cetuspcr/Cetus-PCR/assets/background_clean.png

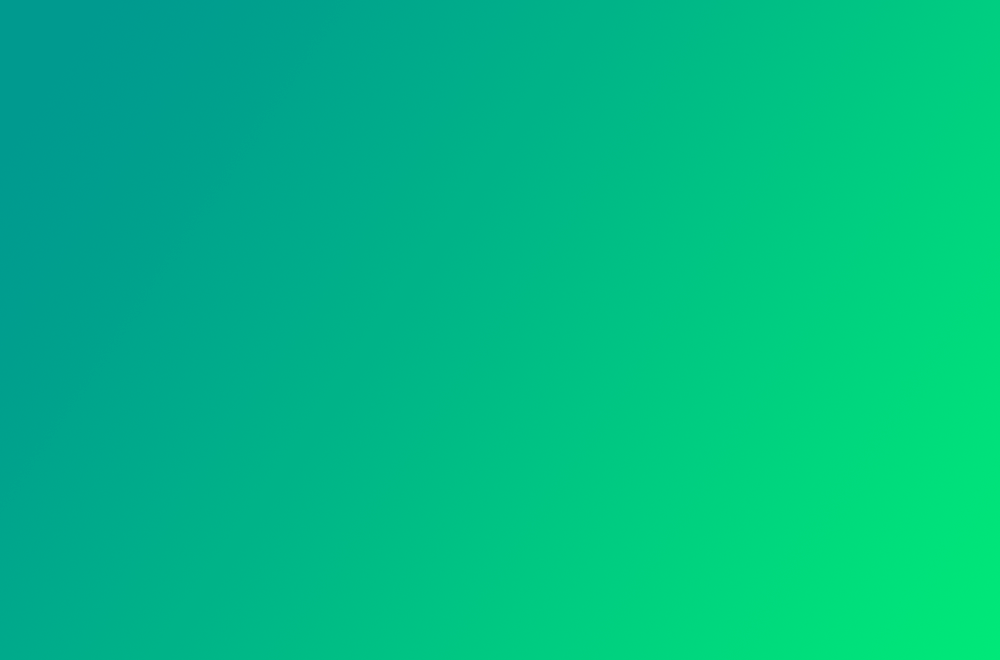
assets/background_clean.png
