cetuspcr/Cetus-PCR/experiment logs/01.csv

Tempo (s) | Y | Set Point
0.0 | 33.69 | 50
0.0 | 33.69 | 50
0.10091447830200195 | 33.69 | 50
0.2020721435546875 | 33.2 | 50
0.3033294677734375 | 33.69 | 50
0.40473127365112305 | 33.2 | 50
0.5053997039794922 | 33.2 | 50
0.6060643196105957 | 33.2 | 50
0.7074980735778809 | 33.2 | 50
0.8095066547393799 | 33.69 | 50
0.9102857112884521 | 33.2 | 50
1.0107948780059814 | 33.69 | 50
1.1115119457244873 | 33.2 | 50
1.2125053405761719 | 33.69 | 50
1.3139410018920898 | 33.69 | 50
1.4150991439819336 | 33.2 | 50
1.5158190727233887 | 33.2 | 50
1.6166791915893555 | 33.69 | 50
1.718376874923706 | 33.2 | 50
1.8188409805297852 | 33.2 | 50
1.9200749397277832 | 33.2 | 50
2.021578788757324 | 33.2 | 50
2.122995615005493 | 33.2 | 50
2.224482774734497 | 33.2 | 50
2.325566291809082 | 33.69 | 50
2.427121877670288 | 33.69 | 50
2.5276989936828613 | 32.71 | 50
2.6286206245422363 | 33.2 | 50
2.7295331954956055 | 33.69 | 50
2.8307366371154785 | 33.69 | 50
2.931636333465576 | 33.2 | 50
3.0328919887542725 | 33.69 | 50
3.1337881088256836 | 33.2 | 50
3.235490560531616 | 33.2 | 50
3.3357677459716797 | 33.69 | 50
3.43656325340271 | 33.69 | 50
3.53780198097229 | 33.2 | 50
3.6384100914001465 | 33.69 | 50
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
