cetuspcr/Cetus-PCR/(commit log)

2019-03-31 Adicionada função para enviar os dados do experimento para porta serial, ainda não implementada.
2019-04-02 Implementada função para comunicação Serial.
2019-04-02 Implementada classe para experimentos
2019-04-04 Implementada funções para
2019-04-04 Rework completo na interface.
    A partir de agora a interface terá 2 janelas, uma onde estará o experimento e outra para executá-lo e editá-lo.
    Foi adicionado um arquivo para as constantes do programa.
    [interface.py]
2019-04-05 Comentários atualizados
    Foram adicionadas descrições para as classes de janelas e constantes internas.
2019-04-06 Implementada função para o botão "Abrir" da CetusPCR
2019-04-06 Função para abrir experimentos modificada
2019-04-07 Implementada função para editar experimentos
2019-04-07 Implementada função para adicionar experimentos
2019-04-07 Implementada função para o botão "Excluir" da CetusPCR
2019-04-08 Botão para retornar adicionado na ExperimentPCR
2019-04-08 Correções para adequação ao PEP8
2019-04-08 Correção de bugs na interface
    [interface.py]
2019-04-09 Adicionada função para validação de texto nas caixas de entrada.
2019-04-09 Correções de bugs na interface
    [constants.py, interface.py]
2019-04-09 Correção nas docstrings de acordo com o PEP8
2019-04-09 Adicionado instruções para configurar um novo ambiente
2019-04-20 Implementação de funções para comunicação serial
2019-04-22 Barra inferior para informações adicionada
2019-04-30 Atualização de nome
2019-04-30 Atualização de link de imagem
2019-05-08 Removido decorador para funções de botão
2019-05-16 Correção de bug ao criar experimento vazio.
    [interface.py]
2019-05-25 Teste de nova estrutura para Frames
2019-05-27 Implementação de conexão automática.
2019-05-27 Atualizado icone de configurações
2019-05-31 Adicionado arquivos arduino.
2019-07-17 Alteração na estrutura dos objetos de experimento.
2019-07-27 Implementação dos protocolos de comunicação entre Python e Arduino.
2019-08-31 Alterada a estrutura do sistema de controle pela vigésima vez
    Implementação do controlador PID (Constantes ainda a serem definidas).
2019-08-31 Design do botão de configurar finalizado.
2019-09-03 Primeira versão da janela de monitoramento finalizada
